qubixal/haven-badge/eink-badge.kicad_pcb

## KiCad design eink-badge.kicad_pcb (2026-10-22)

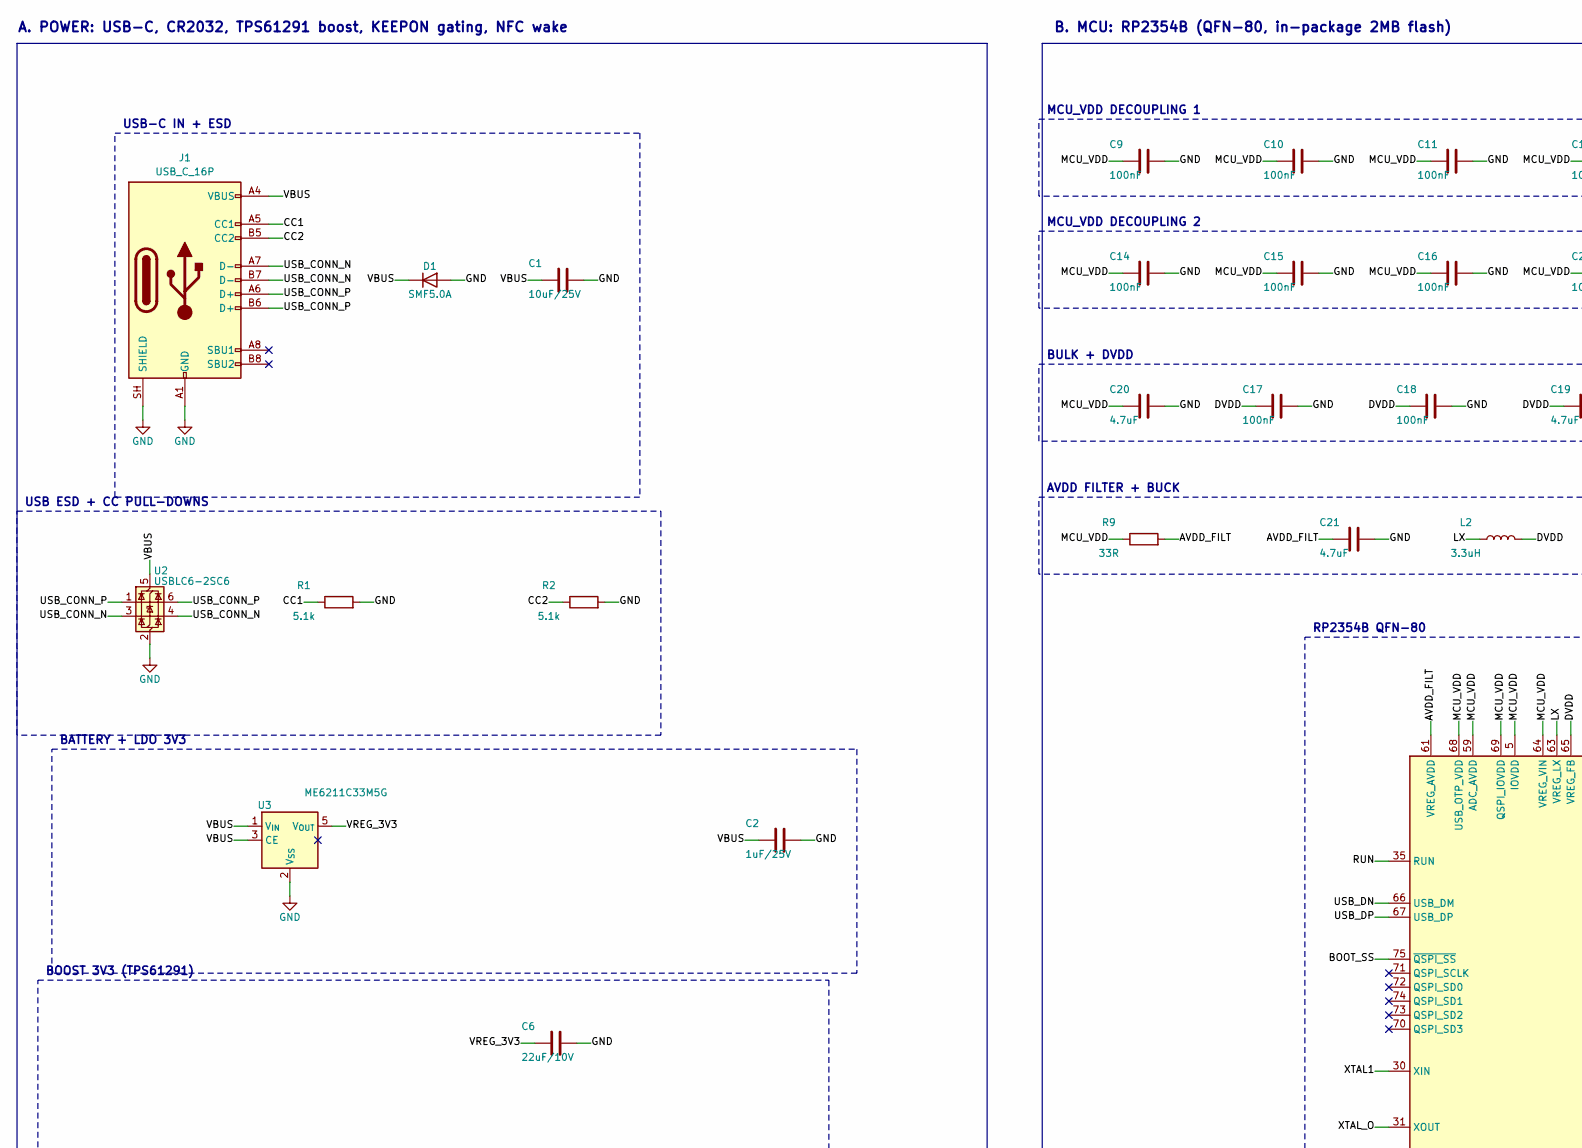
[picture p1: schematic eink-badge.kicad_sch, E-ink badge, part in row 1, column 1]

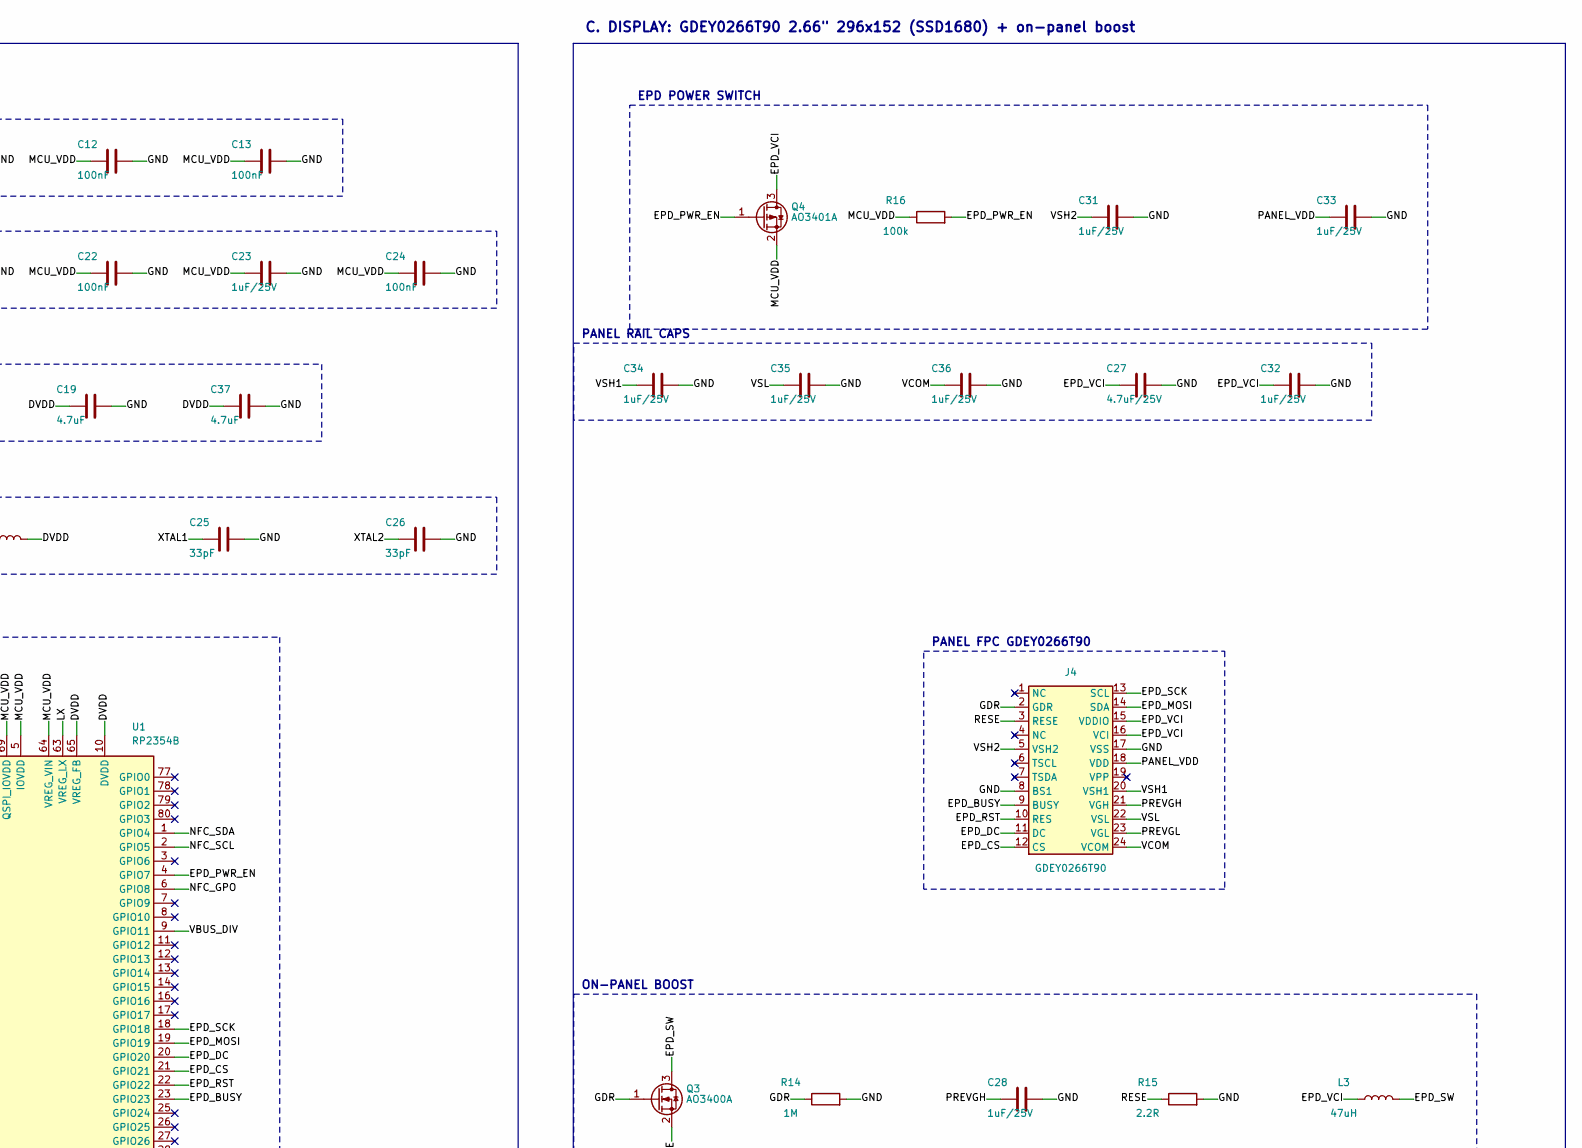
[picture p2: schematic eink-badge.kicad_sch, E-ink badge, part in row 1, column 2]

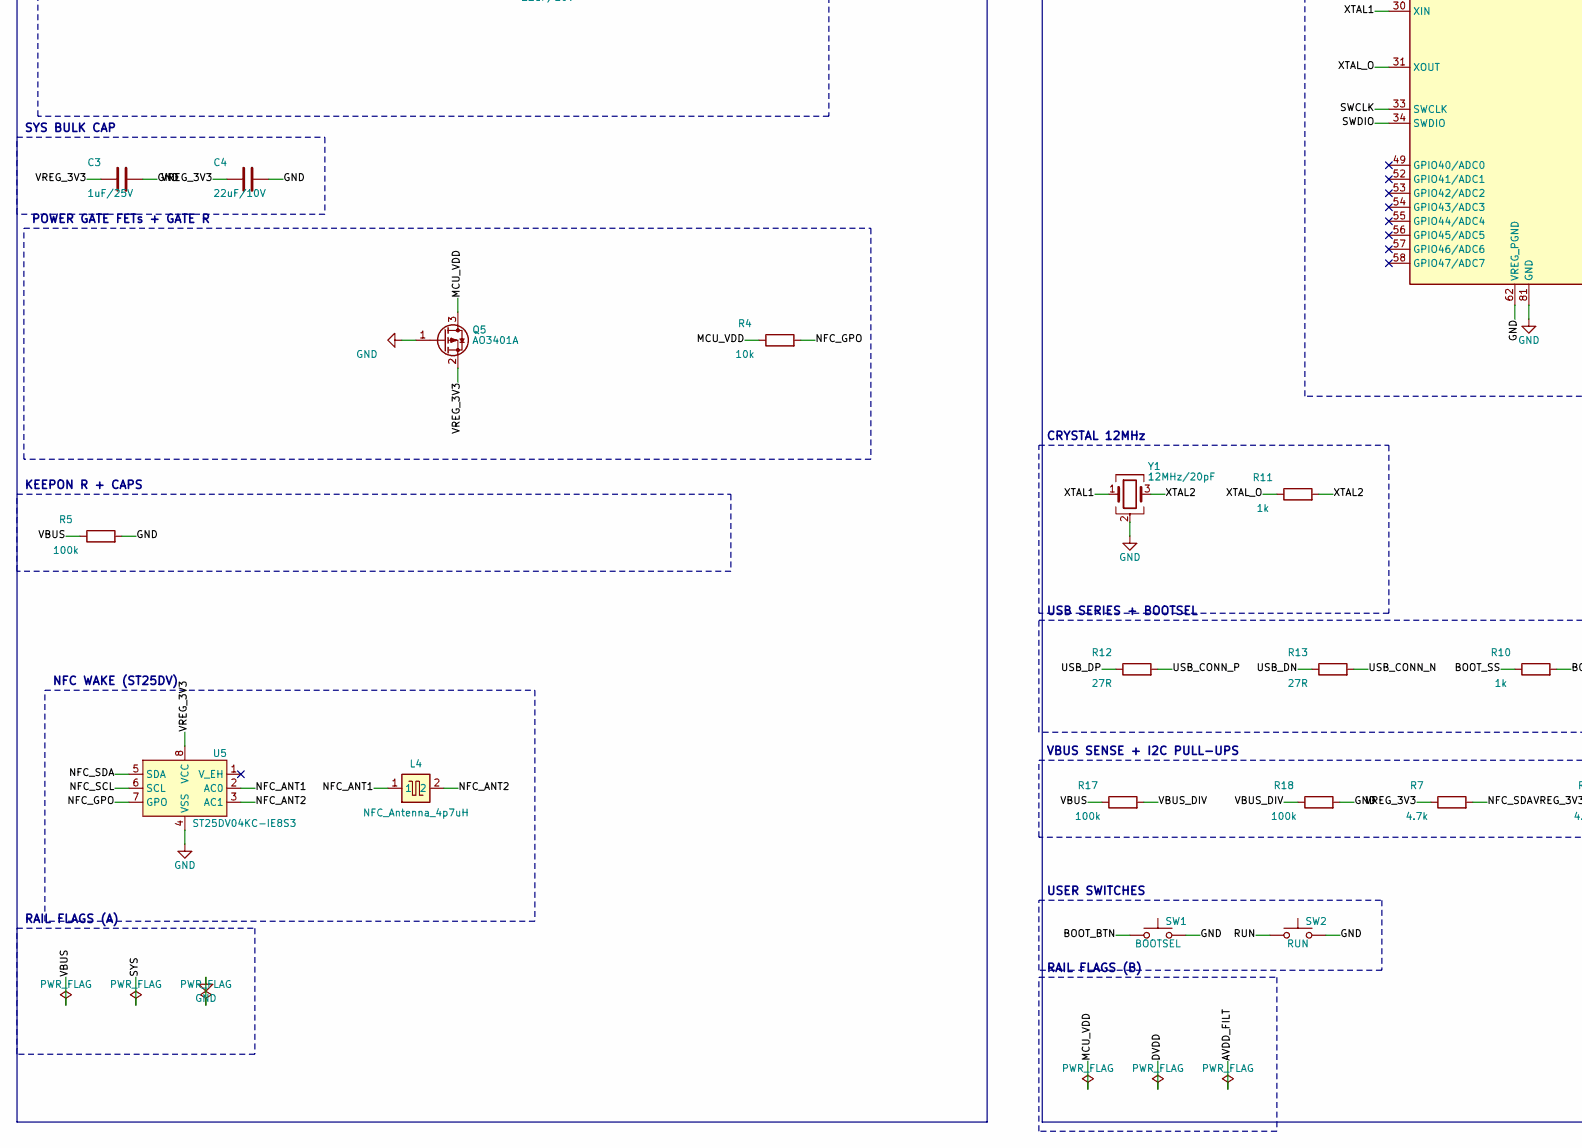
[picture p3: schematic eink-badge.kicad_sch, E-ink badge, part in row 2, column 1]

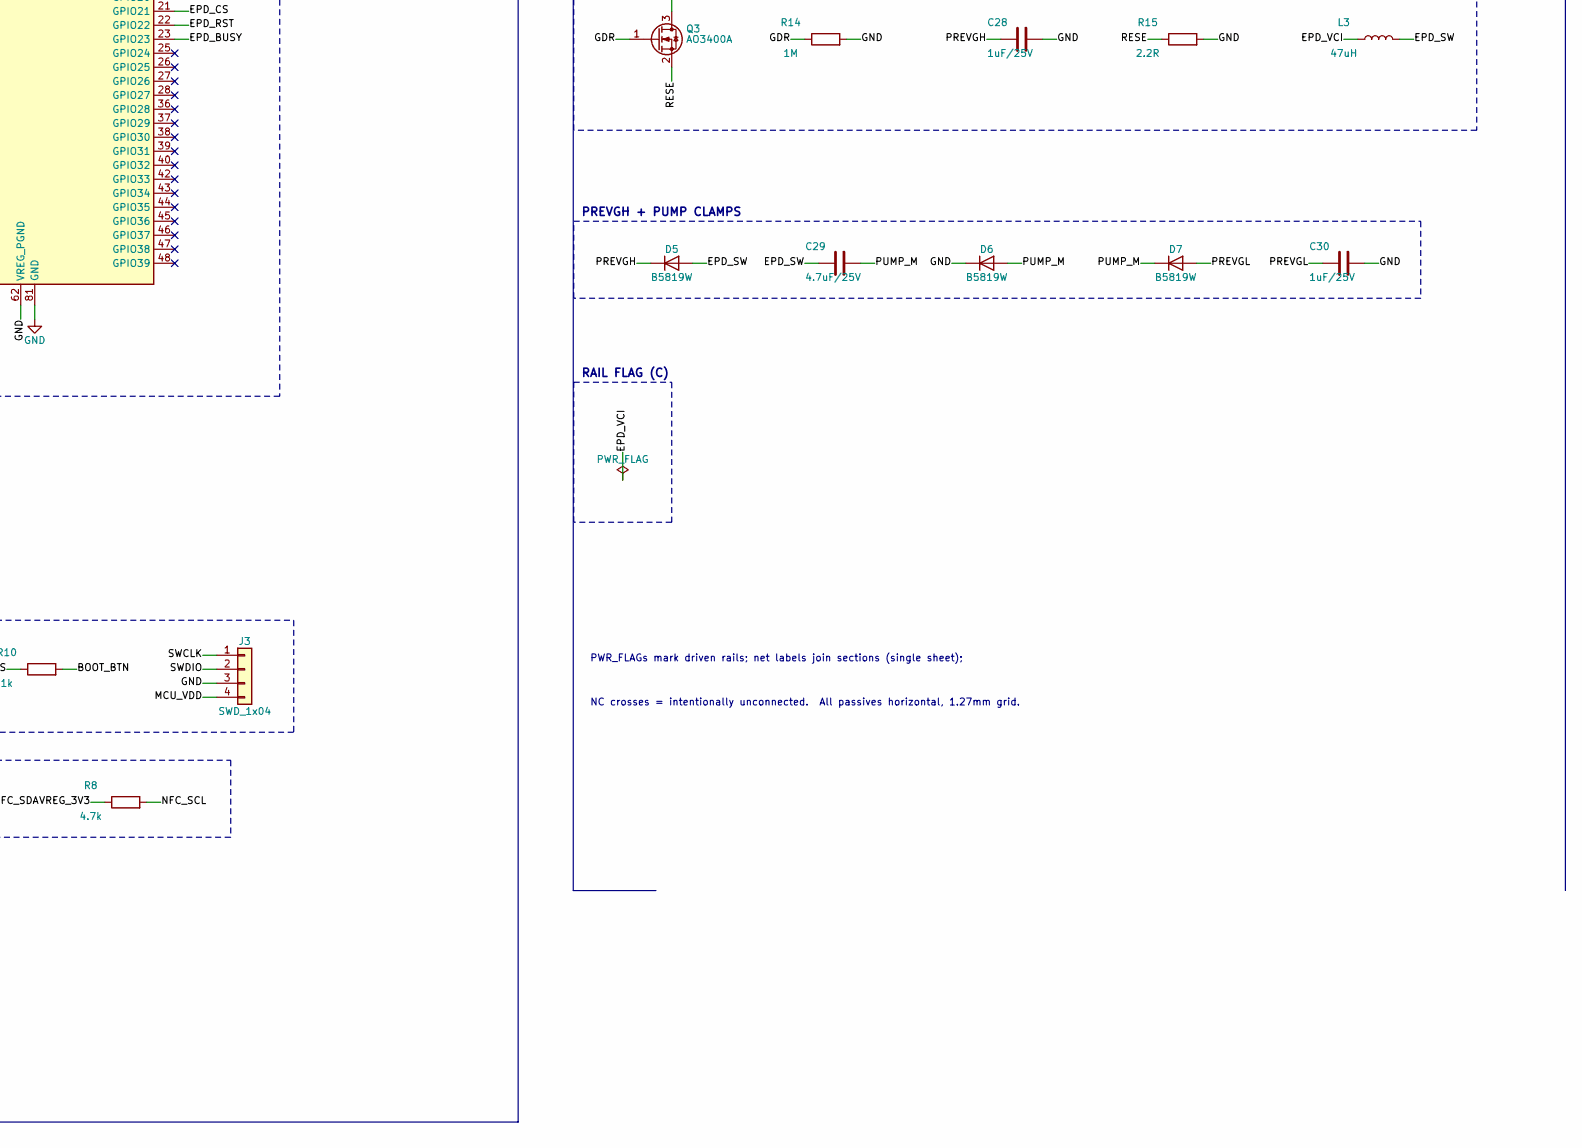
[picture p4: schematic eink-badge.kicad_sch, E-ink badge, part in row 2, column 2]

Parts:
C1: 10uF/25V; C_0805_2012Metric
C2, C3, C23, C31, C32, C33, C34, C35, C36: 1uF/25V; C_0603_1608Metric
C4, C6: 22uF/10V; C_0805_2012Metric
C9, C10, C11, C12, C13, C14, C15, C16, C17, C18, C22, C24: 100nF; C_0402_1005Metric
C19, C20, C21, C37: 4.7uF; C_0603_1608Metric
C25, C26: 33pF; C_0402_1005Metric
C27, C29: 4.7uF/25V; C_0805_2012Metric
C28, C30: 1uF/25V; C_0805_2012Metric
D1: SMF5.0A; D_SOD-123F
D5, D6, D7: B5819W; D_SOD-123
J1: USB_C_16P; USB_C_Receptacle_HRO_TYPE-C-31-M-12
J3: SWD_1x04; SWD_4p_SMD_P2.54mm
J4: GDEY0266T90; Jushuo_AFC07-S24FCA-00_1x24-1MP_P0.50_Horizontal
L2: 3.3uH; L_Changjiang_FNR3015S
L3: 47uH; L_Changjiang_FNR3015S
L4: NFC_Antenna_4p7uH
Q3: AO3400A; SOT-23
Q4, Q5: AO3401A; SOT-23
R1, R2: 5.1k; R_0402_1005Metric
R4: 10k; R_0402_1005Metric
R5, R16, R17, R18: 100k; R_0402_1005Metric
R7, R8: 4.7k; R_0402_1005Metric
R9: 33R; R_0402_1005Metric
R10, R11: 1k; R_0402_1005Metric
R12, R13: 27R; R_0402_1005Metric
R14: 1M; R_0402_1005Metric
R15: 2.2R; R_0402_1005Metric
SW1: BOOTSEL; SW_TS1187A_2pad
SW2: RUN; SW_TS1187A_2pad
U1: RP2354B; QFN-80-1EP_10x10mm_P0.4mm_EP3.4x3.4mm
U2: USBLC6-2SC6; SOT-23-6
U3: ME6211C33M5G; SOT-23-5
U5: ST25DV04KC-IE8S3; SOIC-8_3.9x4.9mm_P1.27mm
Y1: 12MHz/20pF; Crystal_SMD_3225-4Pin_3.2x2.5mm

Connections:
/AVDD_FILT: C21.1, R9.2, U1.61 (VREG_AVDD)
/BOOT_BTN: R10.2, SW1.1
/BOOT_SS: R10.1, U1.75 (~QSPI_SS)
/CC1: J1.A5 (CC1), R1.1
/CC2: J1.B5 (CC2), R2.1
/EPD_BUSY: J4.9 (BUSY), U1.23 (GPIO23)
/EPD_CS: J4.12 (CS), U1.21 (GPIO21)
/EPD_DC: J4.11 (DC), U1.20 (GPIO20)
/EPD_MOSI: J4.14 (SDA), U1.19 (GPIO19)
/EPD_PWR_EN: Q4.1 (G), R16.2, U1.4 (GPIO7)
/EPD_RST: J4.10 (RES), U1.22 (GPIO22)
/EPD_SCK: J4.13 (SCL), U1.18 (GPIO18)
/EPD_SW: C29.1, D5.2 (A), L3.2, Q3.3 (D)
/EPD_VCI: C27.1, C32.1, J4.15 (VDDIO), J4.16 (VCI), L3.1, Q4.3 (D)
/GDR: J4.2 (GDR), Q3.1 (G), R14.1
/LX: L2.1, U1.63 (VREG_LX)
/MCU_VDD: C9.1, C10.1, C11.1, C12.1, C13.1, C14.1, C15.1, C16.1, C20.1, C22.1, C23.1, C24.1, J3.4, Q4.2 (S), Q5.3 (D), R4.1, R9.1, R16.1, U1.5 (IOVDD), U1.15 (IOVDD), U1.24 (IOVDD), U1.29 (IOVDD), U1.41 (IOVDD), U1.50 (IOVDD), U1.59 (ADC_AVDD), U1.60 (IOVDD), U1.64 (VREG_VIN), U1.68 (USB_OTP_VDD), U1.69 (QSPI_IOVDD), U1.76 (IOVDD)
/NFC_ANT1: L4.1, U5.2 (AC0)
/NFC_ANT2: L4.2, U5.3 (AC1)
/NFC_GPO: R4.2, U1.6 (GPIO8), U5.7 (GPO)
/NFC_SCL: R8.2, U1.2 (GPIO5), U5.6 (SCL)
/NFC_SDA: R7.2, U1.1 (GPIO4), U5.5 (SDA)
/PANEL_VDD: C33.1, J4.18 (VDD)
/PREVGH: C28.1, D5.1 (K), J4.21 (VGH)
/PREVGL: C30.1, D7.2 (A), J4.23 (VGL)
/PUMP_M: C29.2, D6.2 (A), D7.1 (K)
/RESE: J4.3 (RESE), Q3.2 (S), R15.1
/RUN: SW2.1, U1.35 (RUN)
/SWCLK: J3.1, U1.33 (SWCLK)
/SWDIO: J3.2, U1.34 (SWDIO)
/USB_CONN_N: J1.A7 (D-), J1.B7 (D-), R13.2, U2.3 (I/O2), U2.4 (I/O2)
/USB_CONN_P: J1.A6 (D+), J1.B6 (D+), R12.2, U2.1 (I/O1), U2.6 (I/O1)
/USB_DN: R13.1, U1.66 (USB_DM)
/USB_DP: R12.1, U1.67 (USB_DP)
/VBUS: C1.1, C2.1, D1.1 (K), J1.A4 (VBUS), J1.A9 (VBUS), J1.B4 (VBUS), J1.B9 (VBUS), R5.1, R17.1, U2.5 (VBUS), U3.1 (V_{IN}), U3.3 (CE)
/VBUS_DIV: R17.2, R18.1, U1.9 (GPIO11)
/VCOM: C36.1, J4.24 (VCOM)
/VREG_3V3: C3.1, C4.1, C6.1, Q5.2 (S), R7.1, R8.1, U3.5 (V_{OUT}), U5.8 (VCC)
/VSH1: C34.1, J4.20 (VSH1)
/VSH2: C31.1, J4.5 (VSH2)
/VSL: C35.1, J4.22 (VSL)
/XTAL1: C25.1, U1.30 (XIN), Y1.1
/XTAL2: C26.1, R11.2, Y1.3
/XTAL_O: R11.1, U1.31 (XOUT)

Notes on the sheet:
A. POWER: USB-C, CR2032, TPS61291 boost, KEEPON gating, NFC wake
B. MCU: RP2354B (QFN-80, in-package 2MB flash)
C. DISPLAY: GDEY0266T90 2.66" 296x152 (SSD1680) + on-panel boost
USB-C IN + ESD
USB ESD + CC PULL-DOWNS
BATTERY + LDO 3V3
BOOST 3V3 (TPS61291)
SYS BULK CAP
POWER GATE FETs + GATE R
KEEPON R + CAPS
NFC WAKE (ST25DV)
RAIL FLAGS (A)
MCU_VDD DECOUPLING 1
MCU_VDD DECOUPLING 2
BULK + DVDD
AVDD FILTER + BUCK
RP2354B QFN-80
CRYSTAL 12MHz
USB SERIES + BOOTSEL
VBUS SENSE + I2C PULL-UPS
USER SWITCHES
RAIL FLAGS (B)
EPD POWER SWITCH
PANEL RAIL CAPS
PANEL FPC GDEY0266T90
ON-PANEL BOOST
PREVGH + PUMP CLAMPS
RAIL FLAG (C)
PWR_FLAGs mark driven rails; net labels join sections (single sheet);
NC crosses = intentionally unconnected. All passives horizontal, 1.27mm grid.

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
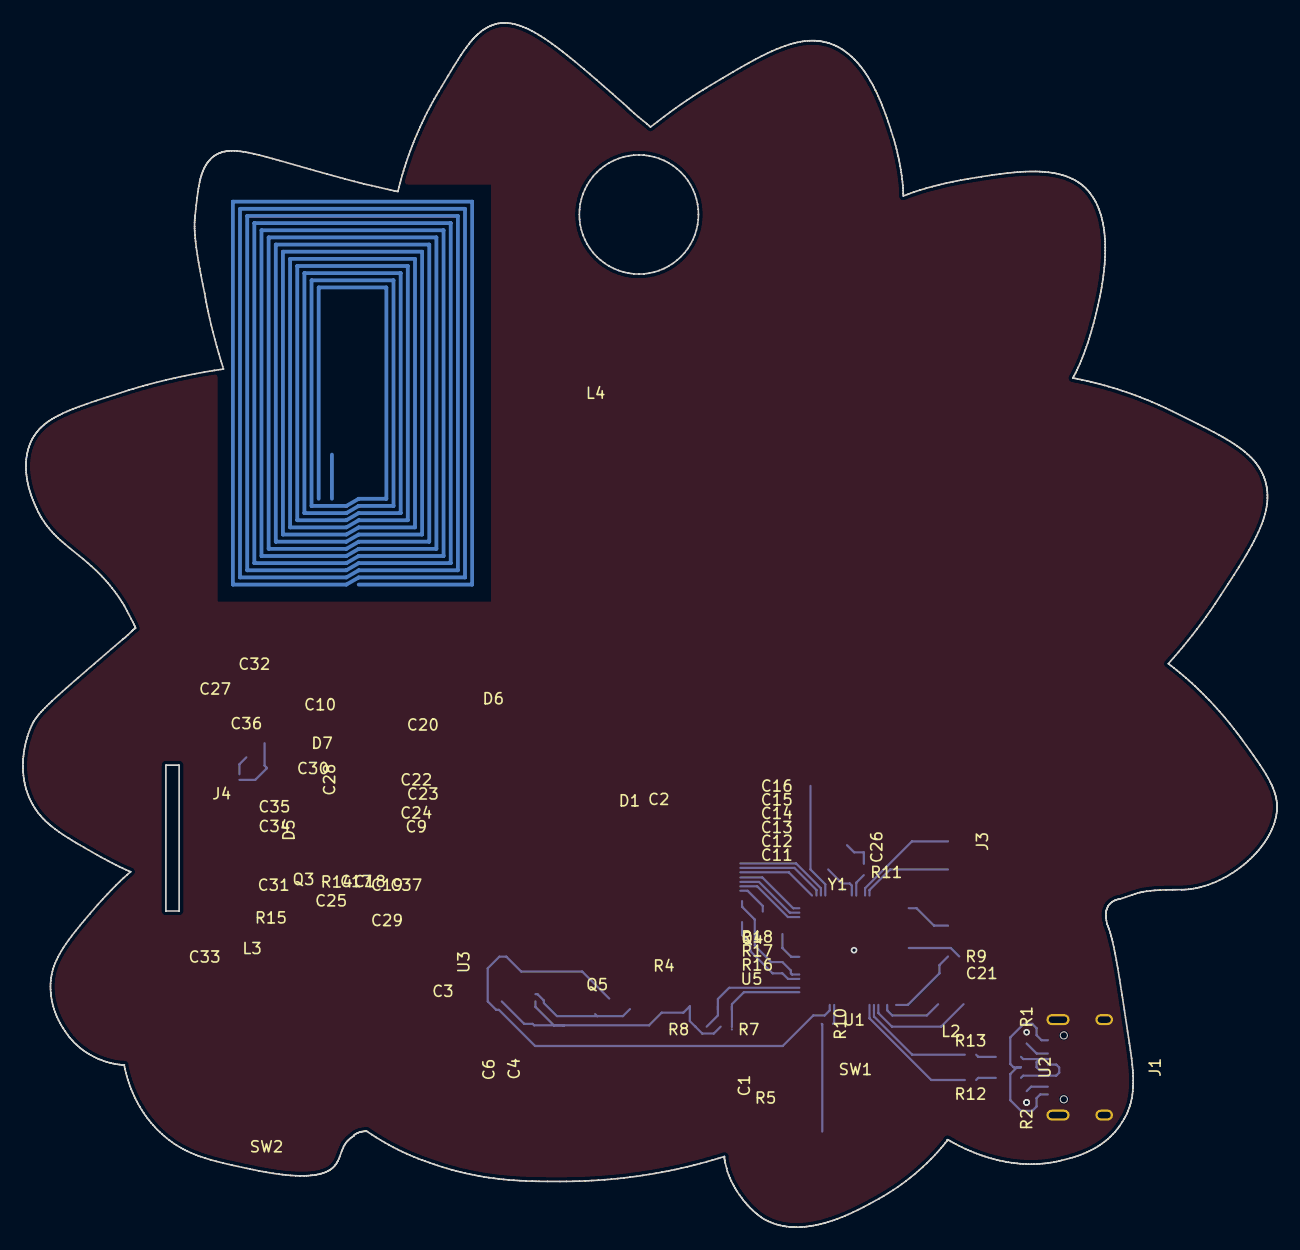
[picture p5: board eink-badge.kicad_pcb from above]

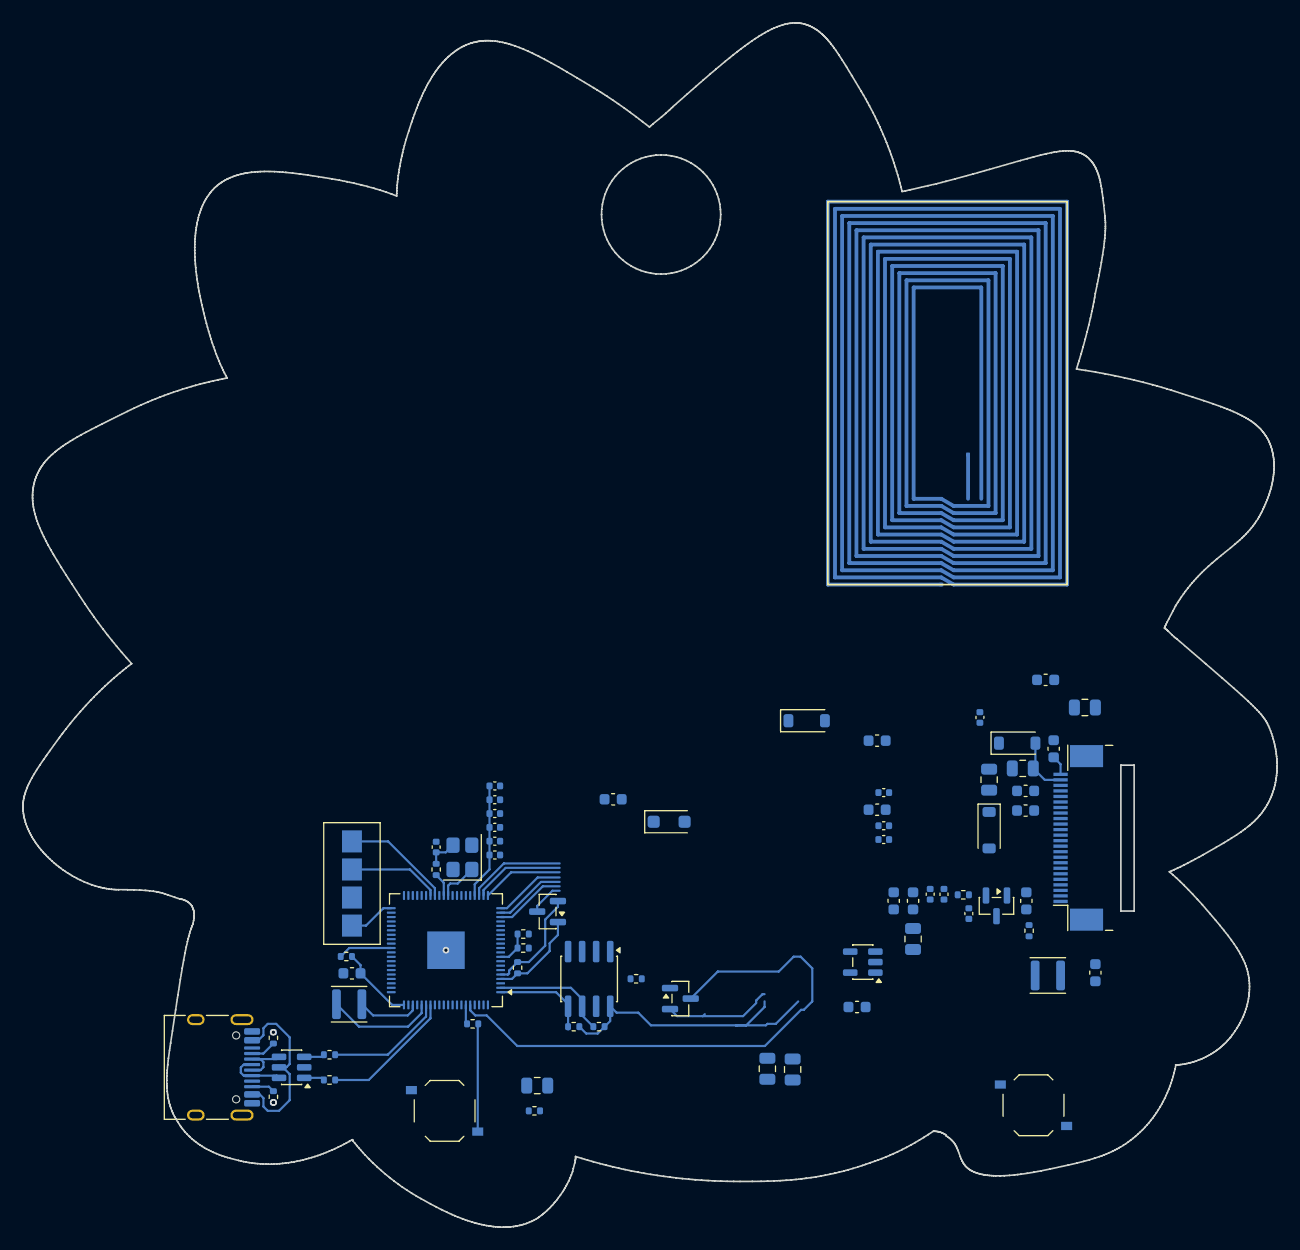
[picture p6: board eink-badge.kicad_pcb from below]

Board: 2 copper layers, 113.5 x 109.0 mm, 70 parts (70 on the bottom side), 46 nets.
