qubixal/haven-badge/(commit log)

2026-09-28 E-ink conference badge schematic (RP2354B + GDEY0266T90 + NFC tap-wake), ERC clean
    [eink-badge.kicad_sch]
2026-10-22 Cut A, real 13.56 MHz PCB antenna, and the NFC update hook
    - Cut A: the coin cell and the regulation chain that exists only to serve it.
    12 parts, 8 nets. The badge is USB-powered. Q5's gate now goes to ground -
    its gate was driven by the KEEPON inverter, and a P-MOSFET with a high gate
    is off, so without that the MCU had no supply at all.
    - L4 is now the antenna: a 19-turn 22 x 35 mm spiral, 0.347 mm trace, drawn as
    board tracks so KiCad exports it. The loop is open 1.2 mm at the centre and
    the ST25DV04KC's internal 28.5 pF bridges that gap, which is the topology
    in AN2866's equivalent circuit. 4.7 uH resonates at 13.75 MHz, the
    datasheet's own reference antenna frequency. No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
    [eink-badge.kicad_pcb, eink-badge.kicad_sch]
